agileinsider/kossel/kisslicer/bedModel.stl

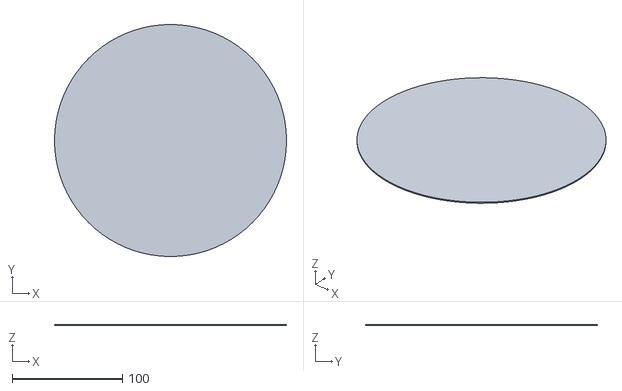
[picture p1: CAD file, 2013-08-04]
kisslicer/bedModel.stl
210.0 x 210.0 x 1.00
