agileinsider/kossel/zprobe_clamp.stl

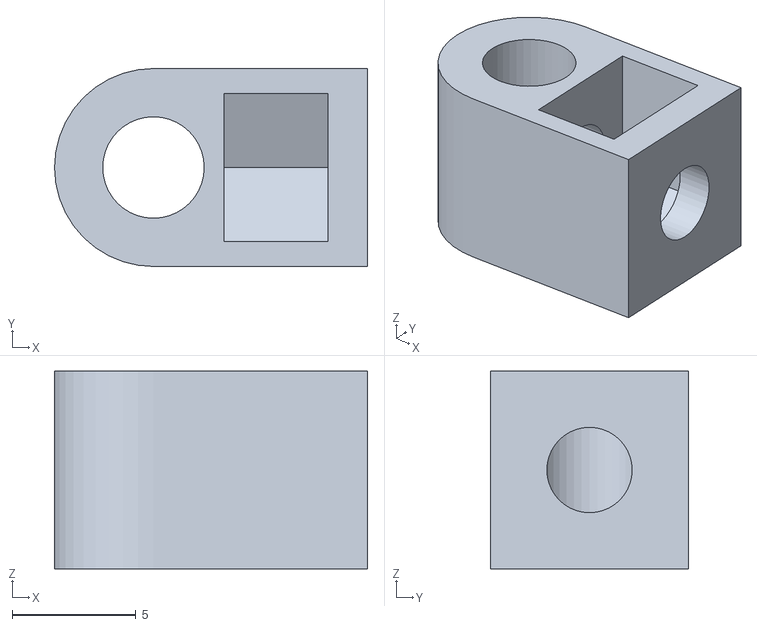
[picture p2: CAD file, 2013-08-18]
zprobe_clamp.stl
12.7 x 8.00 x 8.00
