agileinsider/kossel/zprobe_tool.stl

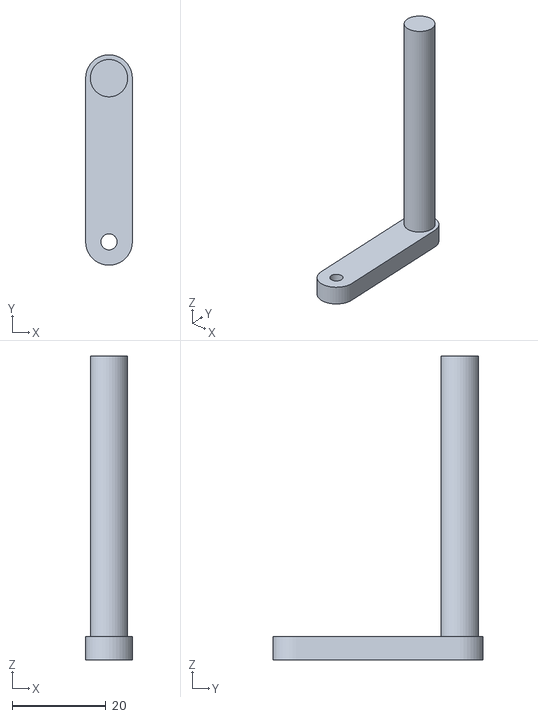
[picture p3: CAD file, 2013-08-18]
zprobe_tool.stl
10.0 x 45.0 x 65.0
