agileinsider/kossel/effector.stl

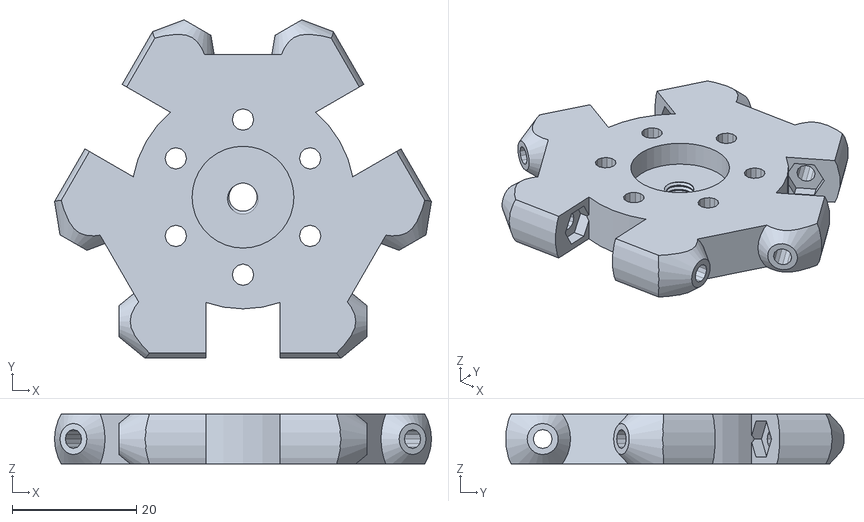
[picture p4: CAD file, 2013-08-18]
effector.stl
60.7 x 54.5 x 8.00
