agileinsider/kossel/m5_internal.stl

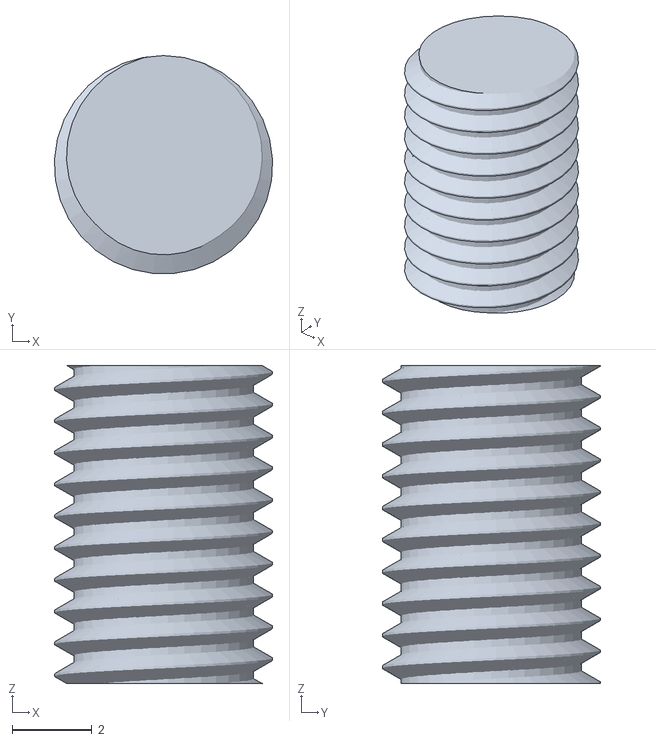
[picture p5: CAD file, 2013-08-18]
m5_internal.stl
5.49 x 5.48 x 8.00
