agileinsider/kossel/retractable.stl

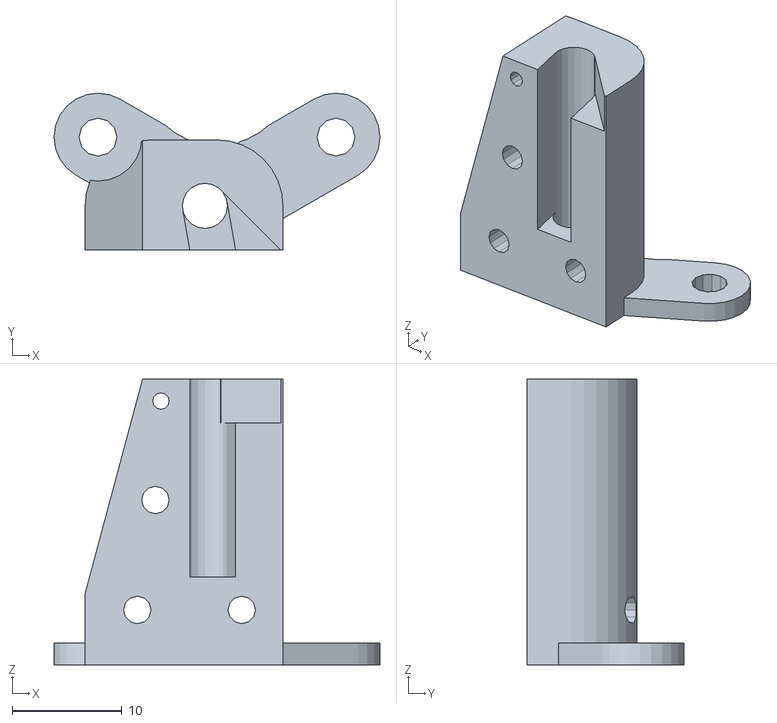
[picture p6: CAD file, 2013-08-18]
retractable.stl
29.7 x 14.2 x 26.0
