agileinsider/kossel/groove_mount.stl

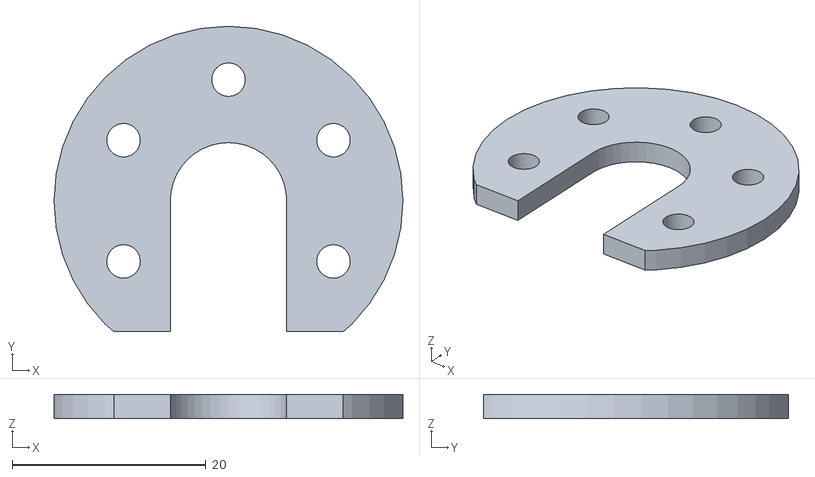
[picture p7: CAD file, 2013-08-18]
groove_mount.stl
36.0 x 31.5 x 2.50
