agileinsider/kossel/fan_mount.stl

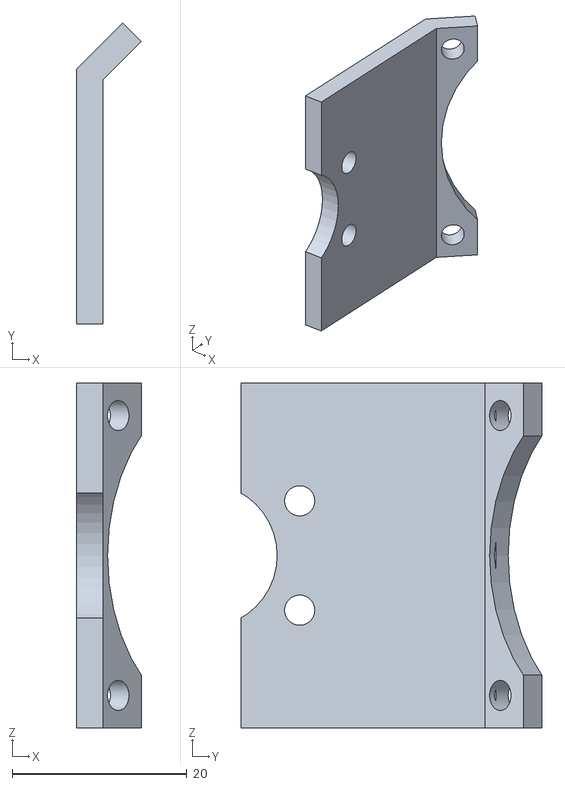
[picture p8: CAD file, 2013-07-07]
fan_mount.stl
7.39 x 34.4 x 39.5
