agileinsider/kossel/belt_clips.stl

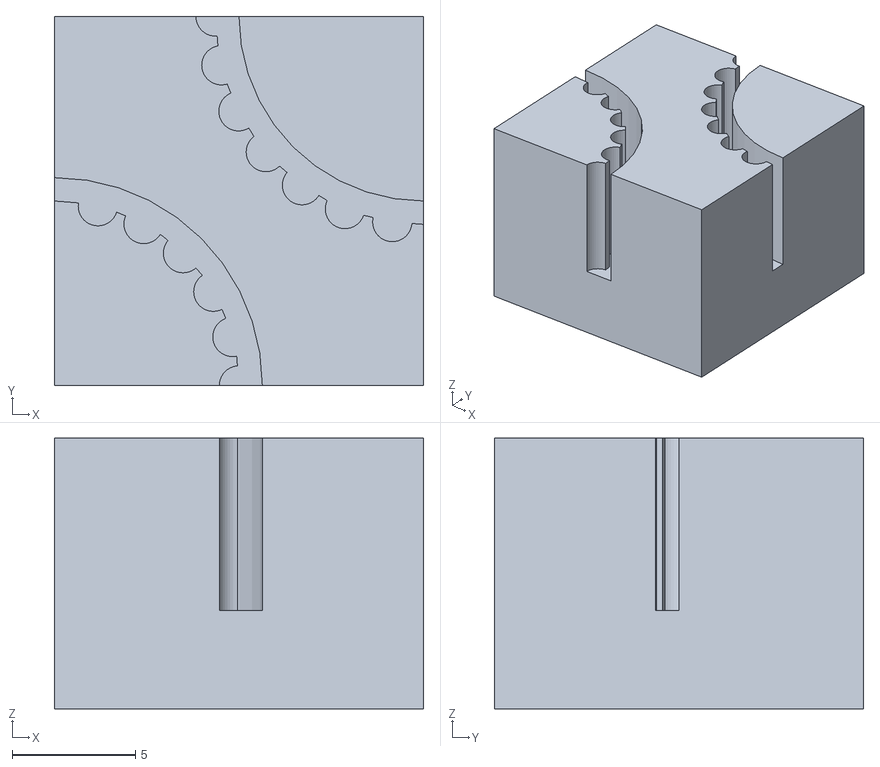
[picture p9: CAD file, 2013-07-07]
belt_clips.stl
15.0 x 15.0 x 11.0
