agileinsider/kossel/glass_clips.stl

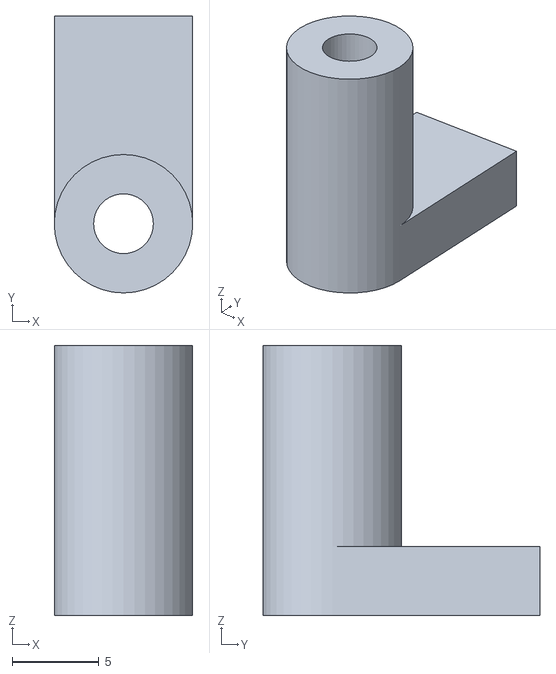
[picture p10: CAD file, 2013-07-07]
glass_clips.stl
8.00 x 16.0 x 15.6
