agileinsider/kossel/m5_internal.scad

use <threads.scad>;

metric_thread(diameter=5.4, pitch=0.8, length=8, internal=true);
