agileinsider/kossel/kisslicer/bedModel.scad

cylinder(r=105, h=1, $fn=80);
