agileinsider/kossel/(list of files, cad)

Other CAD files:
fan_mount.scad
