agileinsider/kossel/kisslicer/_styles.ini

[printrbot (default)]
layer_thickness_mm=0.2
extrusion_width_mm=0.4
num_loops=3
skin_thickness_mm=0.4
infill_extrusion_width=0.4
infill_density_denominator=3
stacked_layers=1
use_destring=1
use_wipe=1
loops_insideout=0
infill_st_oct_rnd=0
inset_surface_xy_mm=0
seam_jitter_degrees=0
seam_depth_scaler=1

[kossel (vase)]
layer_thickness_mm=0.2
extrusion_width_mm=0.5
num_loops=2
skin_thickness_mm=1
infill_extrusion_width=0.5
infill_density_denominator=10
stacked_layers=1
use_destring=0
use_wipe=0
loops_insideout=0
infill_st_oct_rnd=0
inset_surface_xy_mm=0
seam_jitter_degrees=0
seam_depth_scaler=1

[printrbot (kossel parts)]
layer_thickness_mm=0.3
extrusion_width_mm=0.4
num_loops=4
skin_thickness_mm=1
infill_extrusion_width=0.4
infill_density_denominator=2
stacked_layers=1
use_destring=1
use_wipe=1
loops_insideout=1
infill_st_oct_rnd=0
inset_surface_xy_mm=0
seam_jitter_degrees=0
seam_depth_scaler=0.6

[kossel (default)]
layer_thickness_mm=0.25
extrusion_width_mm=0.5
num_loops=3
skin_thickness_mm=0.5
infill_extrusion_width=0.5
infill_density_denominator=2
stacked_layers=1
use_destring=1
use_wipe=1
loops_insideout=0
infill_st_oct_rnd=0
inset_surface_xy_mm=0
seam_jitter_degrees=0
seam_depth_scaler=1

[printrbot (gears)]
layer_thickness_mm=0.3
extrusion_width_mm=0.4
num_loops=1
skin_thickness_mm=1
infill_extrusion_width=0.4
infill_density_denominator=1
stacked_layers=1
use_destring=1
use_wipe=1
loops_insideout=1
infill_st_oct_rnd=0
inset_surface_xy_mm=0
seam_jitter_degrees=0
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
layer_thickness_mm=0.15
extrusion_width_mm=0.4
num_loops=2
skin_thickness_mm=0.3
infill_extrusion_width=0.4
infill_density_denominator=3
stacked_layers=1
use_destring=1
use_wipe=1
loops_insideout=0
infill_st_oct_rnd=0
inset_surface_xy_mm=0
seam_jitter_degrees=0
seam_depth_scaler=1
