agileinsider/kossel/kisslicer/_materials.ini

[Mini Kossel PLA]
g_code_matl=3B204D617962652073657420736F6D65206D6174657269616C2D737065636966696320472D636F64653F
fan_Z_mm=0
fan_loops_percent=100
fan_inside_percent=100
fan_cool_percent=100
temperature_C=225
keep_warm_C=10
first_layer_C=225
bed_C=65
sec_per_C_per_C=0.006
flow_min_mm3_per_s=0.1
flow_max_mm3_per_s=20
destring_suck=9
destring_prime=9
destring_min_mm=1
destring_trigger_mm=3
destring_speed_mm_per_s=100
Z_lift_mm=0.3
min_layer_time_s=20
wipe_mm=2
cost_per_cm3=0.0625
flowrate_tweak=1
fiber_dia_mm=1.8
color=4009689088

[printrbot (PLA)]
g_code_matl=3B204D617962652073657420736F6D65206D6174657269616C2D737065636966696320472D636F64653F
fan_Z_mm=0.5
fan_loops_percent=100
fan_inside_percent=100
fan_cool_percent=100
temperature_C=185
keep_warm_C=100
first_layer_C=195
bed_C=65
sec_per_C_per_C=0.006
flow_min_mm3_per_s=0.1
flow_max_mm3_per_s=20
destring_suck=1.25
destring_prime=1.25
destring_min_mm=1
destring_trigger_mm=100
destring_speed_mm_per_s=100
Z_lift_mm=0
min_layer_time_s=10
wipe_mm=3
cost_per_cm3=0.0491
flowrate_tweak=1
fiber_dia_mm=2.95
color=4009689088

[printrbot (ABS)]
g_code_matl=3B204D617962652073657420736F6D65206D6174657269616C2D737065636966696320472D636F64653F
fan_Z_mm=0.5
fan_loops_percent=0
fan_inside_percent=0
fan_cool_percent=0
temperature_C=245
keep_warm_C=100
first_layer_C=245
bed_C=85
sec_per_C_per_C=0.006
flow_min_mm3_per_s=0.1
flow_max_mm3_per_s=20
destring_suck=1.25
destring_prime=1.25
destring_min_mm=1
destring_trigger_mm=100
destring_speed_mm_per_s=100
Z_lift_mm=0
min_layer_time_s=1
wipe_mm=3
cost_per_cm3=0.0491
flowrate_tweak=1
fiber_dia_mm=2.95
color=4009689088

[printrbot (ninjaflex)]
g_code_matl=3B204D617962652073657420736F6D65206D6174657269616C2D737065636966696320472D636F64653F
fan_Z_mm=0
fan_loops_percent=100
fan_inside_percent=100
fan_cool_percent=100
temperature_C=215
keep_warm_C=100
first_layer_C=215
bed_C=30
sec_per_C_per_C=0.006
flow_min_mm3_per_s=0.1
flow_max_mm3_per_s=20
destring_suck=2
destring_prime=2
destring_min_mm=1
destring_trigger_mm=3
destring_speed_mm_per_s=100
Z_lift_mm=0
min_layer_time_s=10
wipe_mm=3
cost_per_cm3=0.0491
flowrate_tweak=1
fiber_dia_mm=2.85
color=4009689088
