agileinsider/kossel/kisslicer/_supports.ini

[default]
support_sheathe=0
support_density=0
support_inflate_mm=0
support_gap_mm=0.5
support_angle_deg=15
support_z_max_mm=-1
sheathe_z_max_mm=-1
raft_mode=1
prime_pillar_mode=0
raft_inflate_mm=2

[ABS]
support_sheathe=0
support_density=0
support_inflate_mm=0
support_gap_mm=0.5
support_angle_deg=46
support_z_max_mm=-1
sheathe_z_max_mm=-1
raft_mode=2
prime_pillar_mode=0
raft_inflate_mm=4

[none]
support_sheathe=0
support_density=0
support_inflate_mm=0
support_gap_mm=0.5
support_angle_deg=15
support_z_max_mm=-1
sheathe_z_max_mm=-1
raft_mode=0
prime_pillar_mode=0
raft_inflate_mm=2
