agileinsider/kossel/(commit log)

2013-06-26 Updated groove mount
    Changes inspired by Brad Hill's groove mount
    [groove_mount.scad, groove_mount.stl]
2013-06-26 Initial fan mount design
    Clips below the groove mount with the same fasteners.
    Autoleveling probe passes through the center M3 hole.
    [fan_mount.scad, fan_mount.stl]
2013-07-03 Groove mount lip radius was too small
    My calipers were improperly zeroed in the earlier revision
    [groove_mount.scad, groove_mount.stl]
2013-07-03 Fan mount iterations
    Current state of work
    [fan_mount.scad]
2013-07-03 Retractable modifications
    1) Increased tunnel size to handle 2.5mm hex (longer and more rigid than
    the 1.5mm hex currently designed for). I'm using a J-Head Mk IV which is
    longer than the Mk V.
    2) Decreased the size of the feet to handle my slightly larger push
    fitting
    [retractable.scad, retractable.stl]
2013-07-04 Make retractable more parametric
    I needed a longer probe to work with my Mk IV J-Head. So I'm using a
    2.5mm hex now instead of the 1.5mm that Johann uses. To support that, I
    modified the design of the retractable and made it more parametric in
    the process.
    [retractable.scad, retractable.stl]
2013-07-04 M3-based probe clamp
    This clamps the probe at the end of the spring, because I didn't have
    anything else on hand to use for the purpose.
    [zprobe_clamp.scad, zprobe_clamp.stl]
2013-07-07 Revised clamp for longer thread
    In the previous version it was too easy to strip the thread by
    overtightening. The new version has a square block that comes off one
    side to give more contact area.
    [zprobe_clamp.scad, zprobe_clamp.stl]
2013-07-07 Glass clips
    For mounting a square bed, optionally heated, to the frame.
    [glass_clips.scad, glass_clips.stl]
2013-07-07 Testing square tooth cutouts
    [belt_clips.scad, belt_clips.stl]
2013-07-07 Went back to round teeth
    Increased tooth radius and reduced belt thickness. The teeth mesh very
    nicely now and the grip is much better than the original version. After
    testing for a few days I'll put it on Thingiverse and call it done.
    [belt_clips.scad, belt_clips.stl]
2013-07-07 Tool for deploy/retract of zprobe
    Mount this to your frame near one of your towers (inside the accessible
    area but outside of your usable print cylinder) for easy deploy/retract.
    I designed this because deploying with my belt require too long of a
    heat shrink tape tube, which would cause accidental deployment in
    certain locations. For retraction, I have a large square bed so that
    there isn't a good place to use for retraction without losing print
    area.
    [zprobe_tool.scad, zprobe_tool.stl]
2013-07-07 Latest pass at the fan mount
    Reworked the scad for simplicity. The previous version was printed face
    down, giving a weak angular joint that eventually broke. This version is
    designed for printing on its side and is generally stronger.
    [fan_mount.scad, fan_mount.stl]
2013-07-10 Added a trapped hex nut
    The last design could be over tightened, stripping the thread. I took a
    lesson from triffid_hunter's gear set and added a trapped nut to provide
    a much larger contact area. It works great now.
    [zprobe_clamp.scad, zprobe_clamp.stl]
2013-07-10 belt_clips: fix graphical artifacts with coincident faces
    [belt_clips.scad]
2013-07-10 belt_clips: refactor to simplify and enable reuse
    [belt_clips.scad]
2013-07-29 Gave the hex nut more space in the zprobe clamp
    If the hex nut is squished against the clamp then it can cause to
    failure during overtightening. I increased the room so that it's a loose
    fit.
    [zprobe_clamp.scad, zprobe_clamp.stl]
2013-07-29 Reset the angle in the retracted position
    I have been overly aggressive and reduced the angle of the ledge that
    the hex key sits on when retracted. This resets the angle to 35 degrees.
    [retractable.scad, retractable.stl]
2013-08-04 kisslicer settings snapshot
    these settings are working very well for ooze/string-free printing with
    my 3mm Bowden.
    key changes:
    1) reduce hotend temperature to reduce ooze rate
    2) do not z-lift, otherwise more filament just oozes out
    3) moderately fast and long retract
2013-08-04 Added 105mm radius bed model
    [bedModel.scad, bedModel.stl]
2013-08-07 Updated Kisslicer settings
    Increased extrusion temp - running it down at ~180C required enough
    pressure that the fitting on my extruder body broke. Staying above 190C
    for the forseeable future.
    [_materials.ini, _styles.ini]
2013-08-18 Modifications for 3mm to 1.75mm conversion
    I've finished switching from 3mm to 1.75mm filament.
    The big changes:
    1) I'm using a 1.75mm Ubi's rather than a 3mm JHead MkIV. The Ubi's is
    about 10mm longer and has other small geometry differences (e.g. groove
    mount) which required modifications across the board.
    2) I'm using an M5-.8 push-fit from SeeMeCNC now. But I had to generate
    the thread model at 5.4mm to account for quirks on my printrbot.
    Other fixes:
    1) zprobe_clamp uses a nyloc nut - it tended to vibrate loose over time
    before
    [effector.scad, effector.stl, groove_mount.scad, groove_mount.stl, m5_internal.scad, m5_internal.stl, retractable.scad, retractable.stl]
2013-08-18 Latest kisslicer settings
    For 1.75mm PLA
2014-07-26 Latest kisslicer settings (pre-heated bed disable)
